mothdotmonster/ok35s/README.md

# OK35s


[click here if you want to get one premade](https://mothdotmonster-shop.square.site/product/ok35s/11)
