mothdotmonster/ok35s/stl/README.md

hardware needed:

- 4x 4mm M3 heat set inserts
- 4x 14mm m3 button head screws

if you want to use the tilt spacer, you'll need
- 2x 20mm m3 button head screws

print four of foot.stl in TPU, the rest prints fine in PLA or whatever
