mothdotmonster/ok35s/stl/tilt spacer.stl

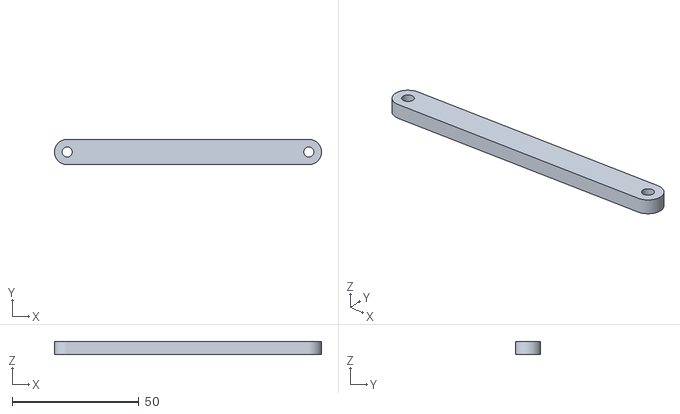
[picture p1: CAD file, 2025-02-20]
stl/tilt spacer.stl
105.2 x 10.0 x 5.00
