mothdotmonster/ok35s/stl/foot.stl

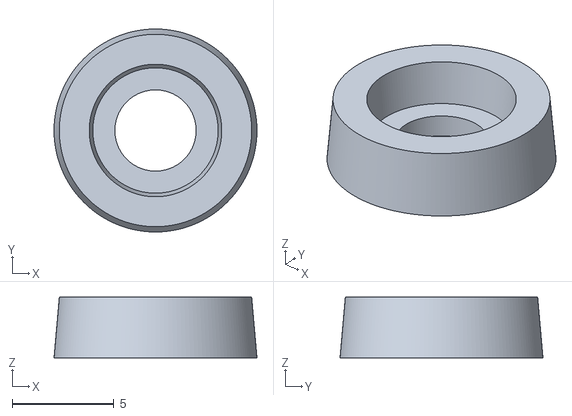
[picture p2: CAD file, 2025-02-20]
stl/foot.stl
10.0 x 10.0 x 3.00
