mothdotmonster/ok35s/stl/top.stl

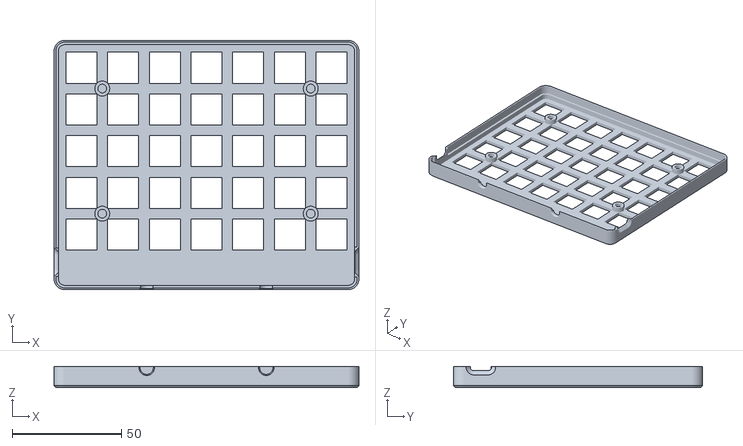
[picture p3: CAD file, 2025-02-20]
stl/top.stl
139.3 x 114.0 x 9.80
