mothdotmonster/ok35s/stl/bottom.stl

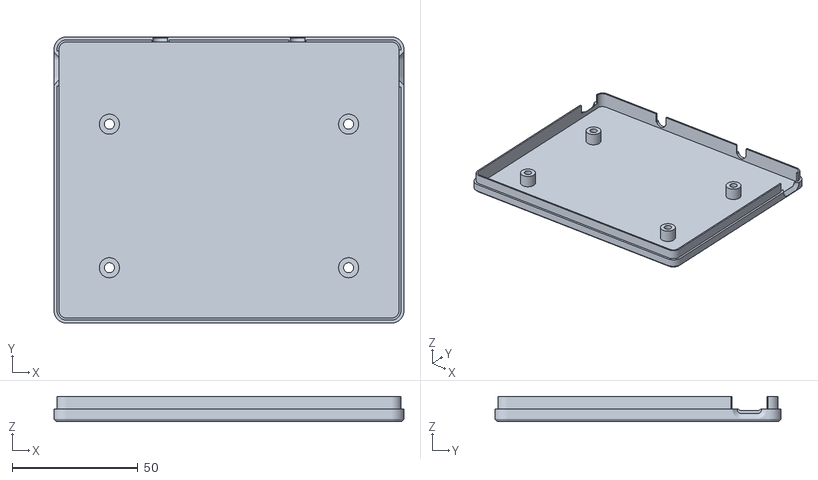
[picture p4: CAD file, 2025-02-20]
stl/bottom.stl
139.3 x 113.9 x 10.00
