mothdotmonster/ok35s/pcb/ok35s.kicad_pcb

## KiCad design pcb/ok35s.kicad_pcb (2025-02-20)

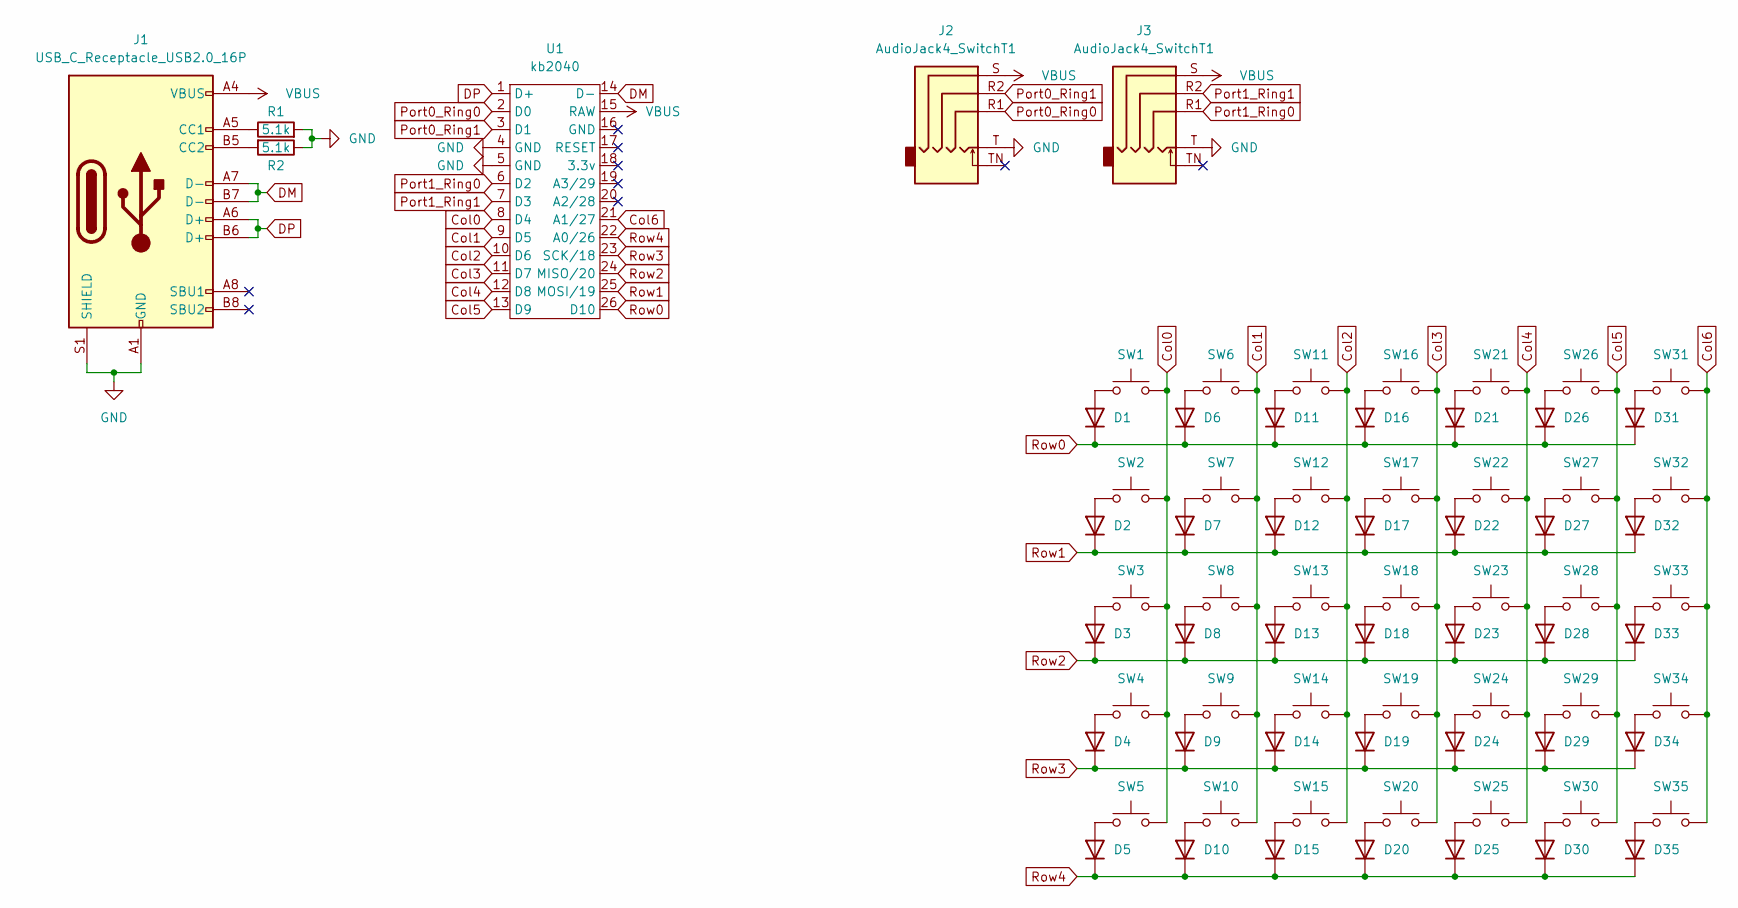
[picture p5: schematic ok35s.kicad_sch]

Parts:
D1, D2, D3, D4, D5, D6, D7, D8, D9, D10, D11, D12, D13, D14, D15, D16, D17, D18, D19, D20, D21, D22, D23, D24, D25, D26, D27, D28, D29, D30, D31, D32, D33, D34, D35: D; D_SOD-323; JLC C2128
J1: USB_C_Receptacle_USB2.0_16P; USB_C_Receptacle_HRO_TYPE-C-31-M-12; JLC C165948
J2, J3: AudioJack4_SwitchT1; Jack_3.5mm_PJ320D_Horizontal; JLC C431535
R1, R2: 5.1k; R_0603_1608Metric; JLC C23186
SW1, SW2, SW3, SW4, SW5, SW6, SW7, SW8, SW9, SW10, SW11, SW12, SW13, SW14, SW15, SW16, SW17, SW18, SW19, SW20, SW21, SW22, SW23, SW24, SW25, SW26, SW27, SW28, SW29, SW30, SW31, SW32, SW33, SW34, SW35: SW_Push; SW_Hotswap_Kailh_MX_1.00u; JLC C41430893
U1: kb2040

Connections:
Col0: SW1.2, SW2.2, SW3.2, SW4.2, SW5.2, U1.8 (D4)
Col1: SW6.2, SW7.2, SW8.2, SW9.2, SW10.2, U1.9 (D5)
Col2: SW11.2, SW12.2, SW13.2, SW14.2, SW15.2, U1.10 (D6)
Col3: SW16.2, SW17.2, SW18.2, SW19.2, SW20.2, U1.11 (D7)
Col4: SW21.2, SW22.2, SW23.2, SW24.2, SW25.2, U1.12 (D8)
Col5: SW26.2, SW27.2, SW28.2, SW29.2, SW30.2, U1.13 (D9)
Col6: SW31.2, SW32.2, SW33.2, SW34.2, SW35.2, U1.21 (A1/27)
DM: J1.A7 (D-), J1.B7 (D-), U1.14 (D-)
DP: J1.A6 (D+), J1.B6 (D+), U1.1 (D+)
GND: J1.A1 (GND), J1.A12 (GND), J1.B1 (GND), J1.B12 (GND), J1.S1 (SHIELD), J2.T, J3.T, R1.2, R2.1, U1.4 (GND), U1.5 (GND)
unnamed: D1.2 (A), SW1.1
unnamed: D2.2 (A), SW2.1
unnamed: D3.2 (A), SW3.1
unnamed: D4.2 (A), SW4.1
unnamed: D5.2 (A), SW5.1
unnamed: D6.2 (A), SW6.1
unnamed: D7.2 (A), SW7.1
unnamed: D8.2 (A), SW8.1
unnamed: D9.2 (A), SW9.1
unnamed: D10.2 (A), SW10.1
unnamed: D11.2 (A), SW11.1
unnamed: D12.2 (A), SW12.1
unnamed: D13.2 (A), SW13.1
unnamed: D14.2 (A), SW14.1
unnamed: D15.2 (A), SW15.1
unnamed: D16.2 (A), SW16.1
unnamed: D17.2 (A), SW17.1
unnamed: D18.2 (A), SW18.1
unnamed: D19.2 (A), SW19.1
unnamed: D20.2 (A), SW20.1
unnamed: D21.2 (A), SW21.1
unnamed: D22.2 (A), SW22.1
unnamed: D23.2 (A), SW23.1
unnamed: D24.2 (A), SW24.1
unnamed: D25.2 (A), SW25.1
unnamed: D26.2 (A), SW26.1
unnamed: D27.2 (A), SW27.1
unnamed: D28.2 (A), SW28.1
unnamed: D29.2 (A), SW29.1
unnamed: D30.2 (A), SW30.1
unnamed: D31.2 (A), SW31.1
unnamed: D32.2 (A), SW32.1
unnamed: D33.2 (A), SW33.1
unnamed: D34.2 (A), SW34.1
unnamed: D35.2 (A), SW35.1
unnamed: J1.A5 (CC1), R1.1
unnamed: J1.B5 (CC2), R2.2
Port0_Ring0: J2.R1, U1.2 (D0)
Port0_Ring1: J2.R2, U1.3 (D1)
Port1_Ring0: J3.R1, U1.6 (D2)
Port1_Ring1: J3.R2, U1.7 (D3)
Row0: D1.1 (K), D6.1 (K), D11.1 (K), D16.1 (K), D21.1 (K), D26.1 (K), D31.1 (K), U1.26 (D10)
Row1: D2.1 (K), D7.1 (K), D12.1 (K), D17.1 (K), D22.1 (K), D27.1 (K), D32.1 (K), U1.25 (MOSI/19)
Row2: D3.1 (K), D8.1 (K), D13.1 (K), D18.1 (K), D23.1 (K), D28.1 (K), D33.1 (K), U1.24 (MISO/20)
Row3: D4.1 (K), D9.1 (K), D14.1 (K), D19.1 (K), D24.1 (K), D29.1 (K), D34.1 (K), U1.23 (SCK/18)
Row4: D5.1 (K), D10.1 (K), D15.1 (K), D20.1 (K), D25.1 (K), D30.1 (K), D35.1 (K), U1.22 (A0/26)
VBUS: J1.A4 (VBUS), J1.A9 (VBUS), J1.B4 (VBUS), J1.B9 (VBUS), J2.S, J3.S, U1.15 (RAW)

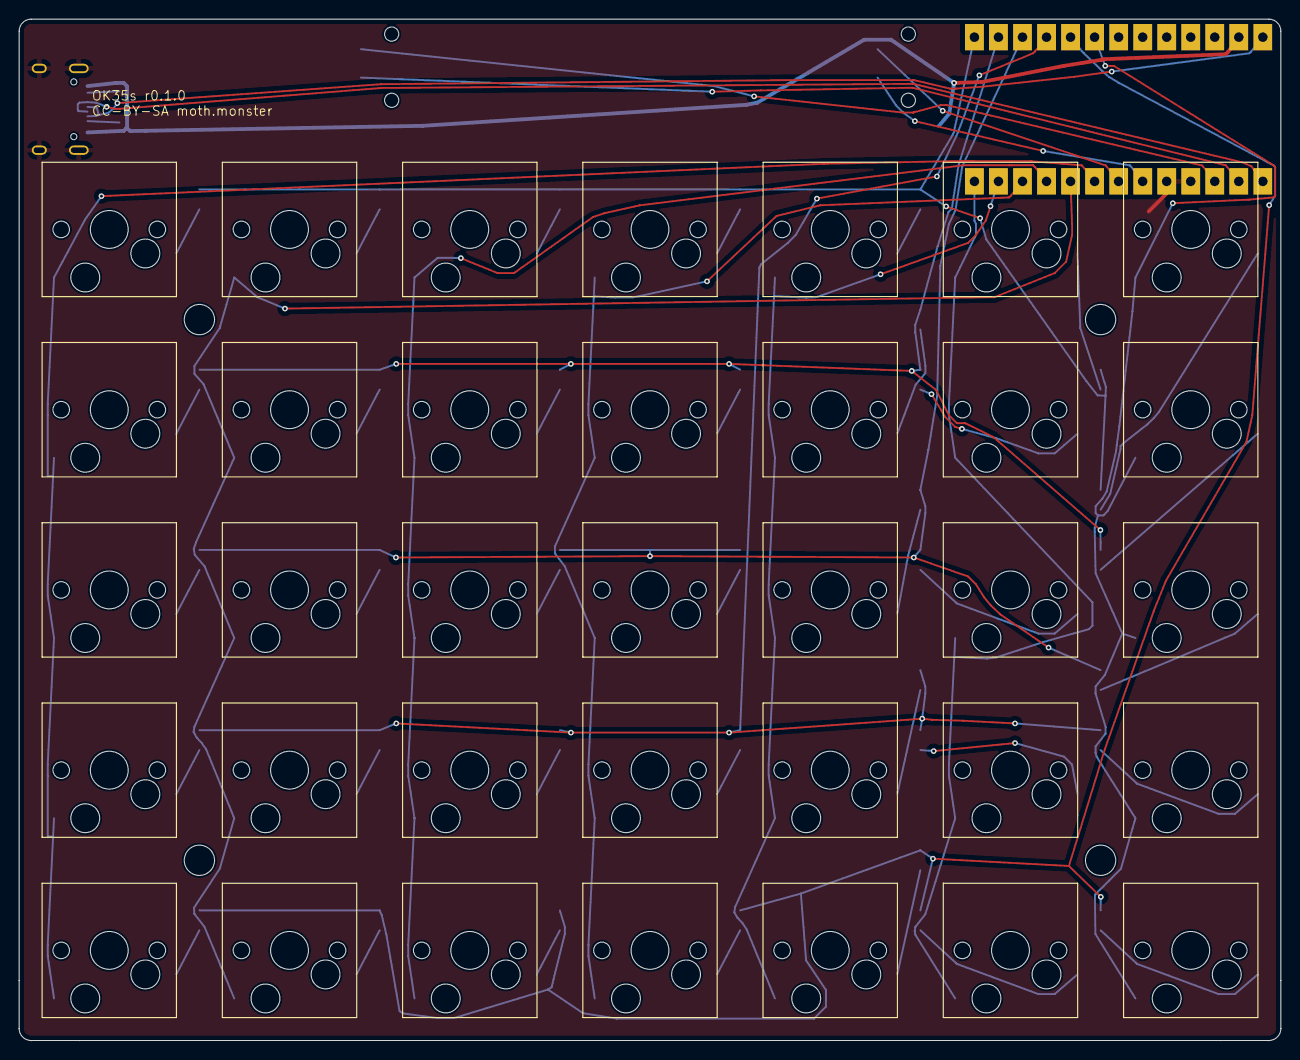
[picture p6: board ok35s.kicad_pcb from above]

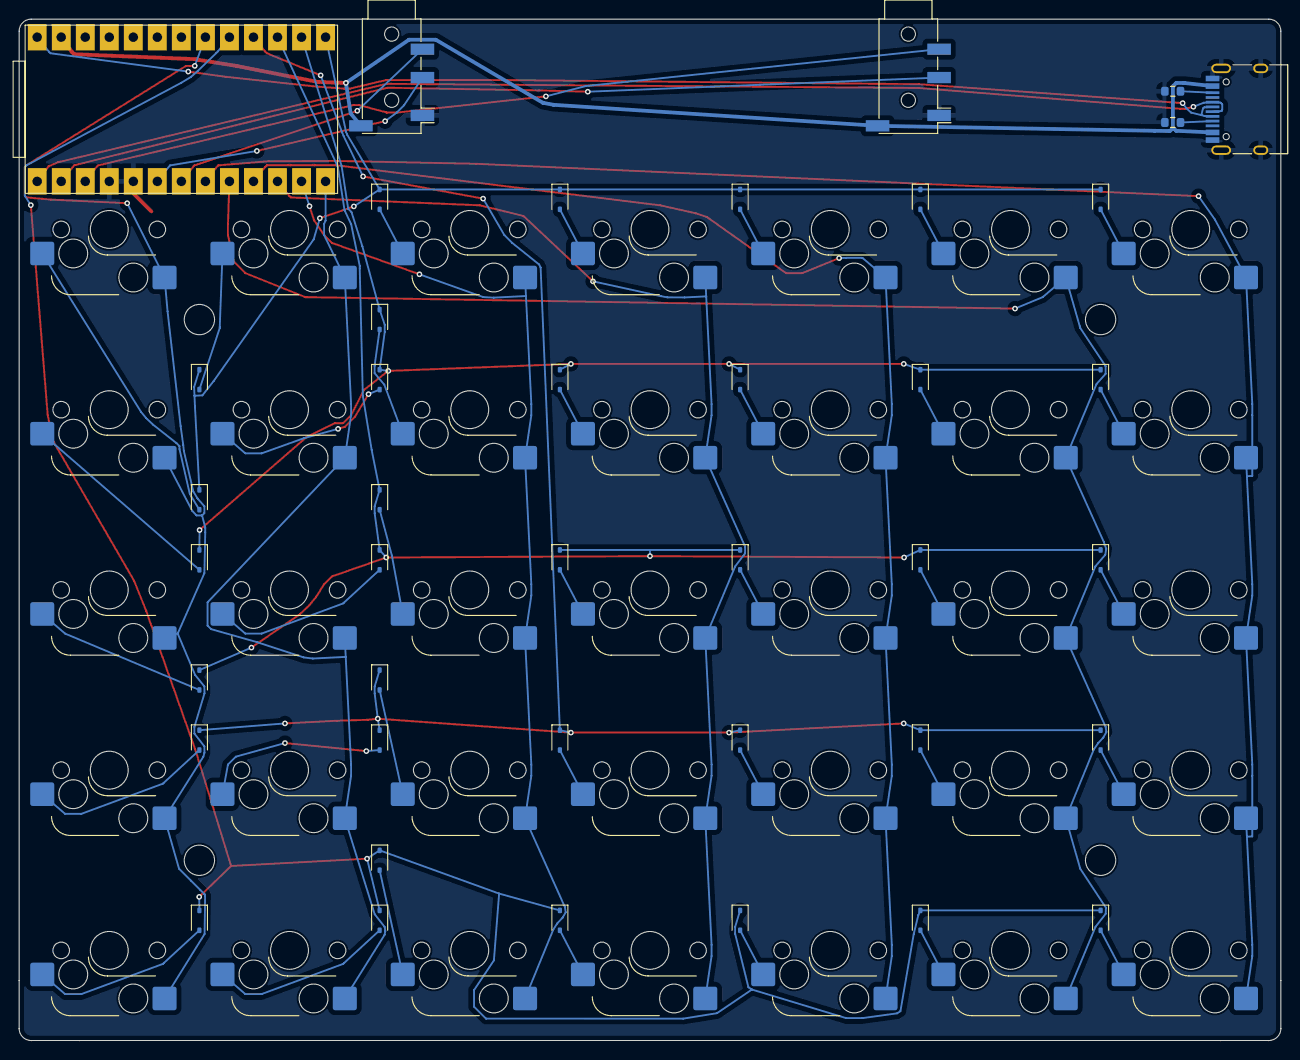
[picture p7: board ok35s.kicad_pcb from below]

Board: 2 copper layers, 133.4 x 108.0 mm, 80 parts (76 on the bottom side), 57 nets.

Other parts of the board:
HOLE1, HOLE2, HOLE3, HOLE4: MountingHole_3.2mm_M3_DIN965
