mothdotmonster/ok35s/firmware/macro/keymap.py

from kmk.keys import KC

keymap = [
[
	KC.F1,  KC.F2,  KC.F3,  KC.F4,  KC.F5,  KC.F6,  KC.F7,
	KC.F8,  KC.F9,  KC.F10, KC.F11, KC.F12, KC.F13, KC.F14,
	KC.F15, KC.F16, KC.F17, KC.F18, KC.F19, KC.F20, KC.F21,
	KC.F22, KC.F23, KC.F24, KC.P1,  KC.P2,  KC.P3,  KC.P4,
	KC.P5,  KC.P6,  KC.P7,  KC.P8,  KC.P9,  KC.P0,  KC.PDOT
]
]
