mothdotmonster/ok35s/(notices)

Notices in the files:
pcb/ok35s.kicad_pcb:
CC-BY-SA moth.monster
